unph4914/Final_project_esd/(commit log)

2023-12-05 Relay attempted
2023-12-07 relay with water interfaced
